shebuildsrobots/gear_wings/full_stepper_plate.stl

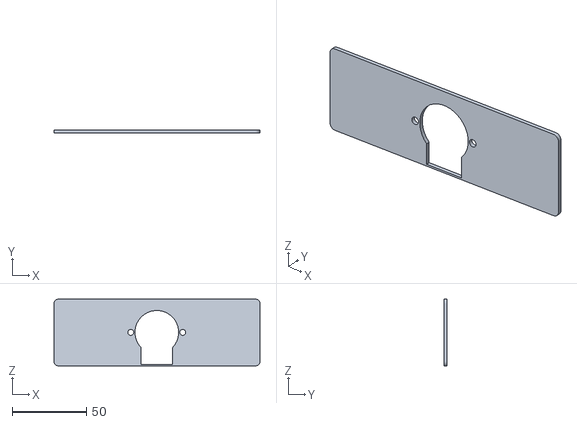
[picture p1: CAD file, 2025-05-30]
full_stepper_plate.stl
138.9 x 2.00 x 45.0
