shebuildsrobots/gear_wings/lid.stl

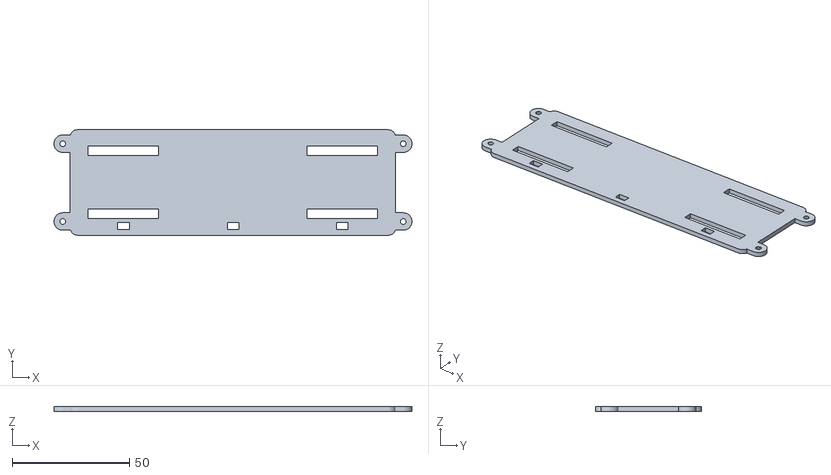
[picture p2: CAD file, 2025-05-30]
lid.stl
153.0 x 45.1 x 2.00
