shebuildsrobots/gear_wings/body.STL

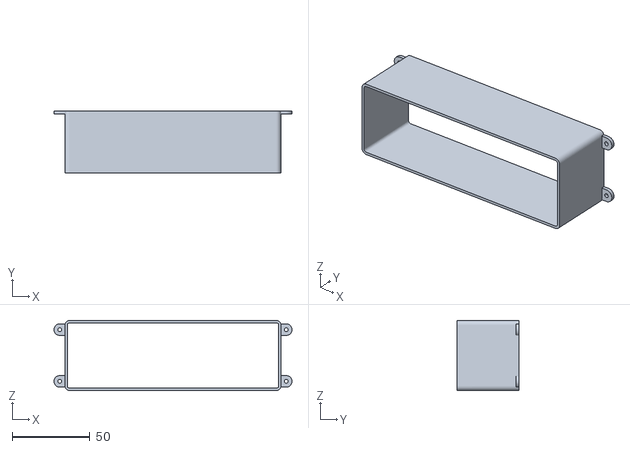
[picture p3: CAD file, 2025-05-30]
body.STL
153.0 x 40.0 x 45.0
