shebuildsrobots/gear_wings/nautilus_right.stl

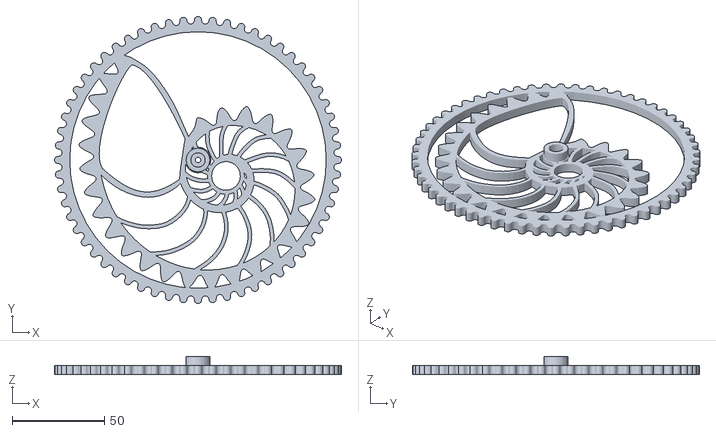
[picture p4: CAD file, 2025-05-30]
nautilus_right.stl
155.7 x 155.7 x 10.0
