shebuildsrobots/gear_wings/center_gear.stl

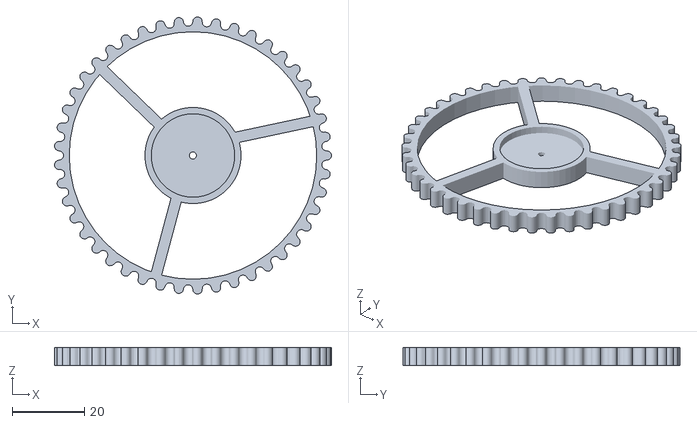
[picture p5: CAD file, 2025-05-30]
center_gear.stl
76.7 x 76.7 x 5.00
