shebuildsrobots/gear_wings/gear_5.stl

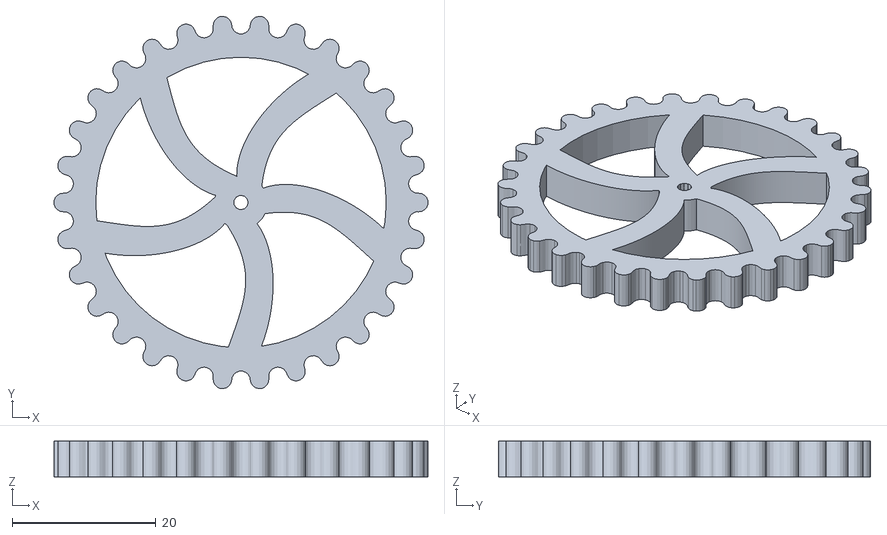
[picture p6: CAD file, 2025-05-30]
gear_5.stl
52.0 x 51.8 x 5.00
