shebuildsrobots/gear_wings/gear_4.stl

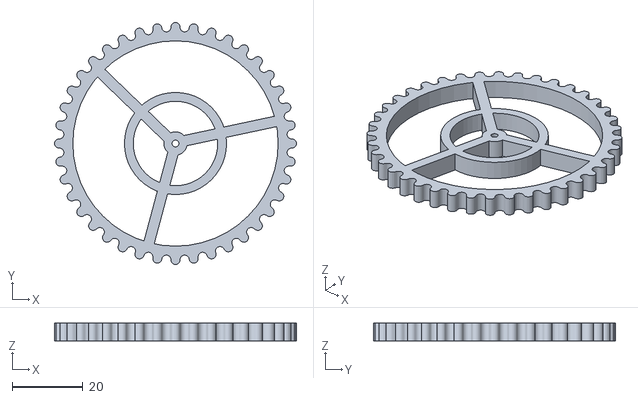
[picture p7: CAD file, 2025-05-30]
gear_4.stl
68.5 x 68.5 x 5.00
