shebuildsrobots/gear_wings/gear_3.stl

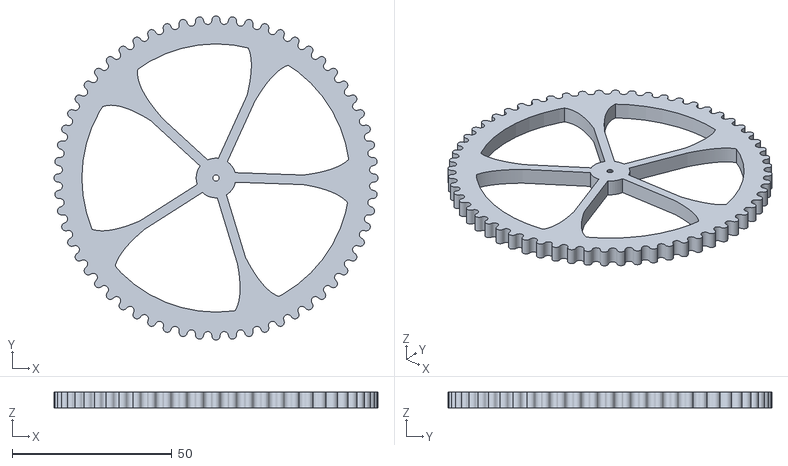
[picture p8: CAD file, 2025-05-30]
gear_3.stl
101.5 x 101.5 x 5.00
