shebuildsrobots/gear_wings/(list of files, cad)

Other CAD files:
nautilus_left.stl
