shebuildsrobots/gear_wings/(commit log)

2025-05-30 Create stepper_trinket.ino
    Upload this file to your Adafruit Trinket.
2025-05-30 add gear stls
    [gear_3.stl, gear_4.stl, gear_5.stl]
